MarekWadinger/firmware-one-openair/docs/3d/reference/Complete Assembly 11AUG22.stp

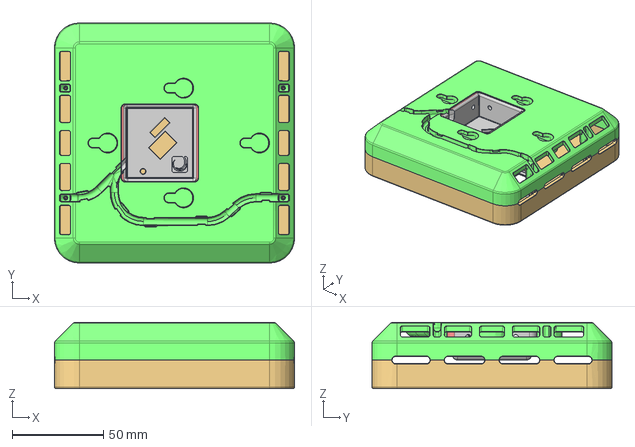
[picture p1: CAD file, 2026-10-09]
docs/3d/reference/Complete Assembly 11AUG22.stp
131.2 x 131.2 x 36.2 mm
