MarekWadinger/firmware-one-openair/docs/3d/reference/airgradient-stand-stl.stl

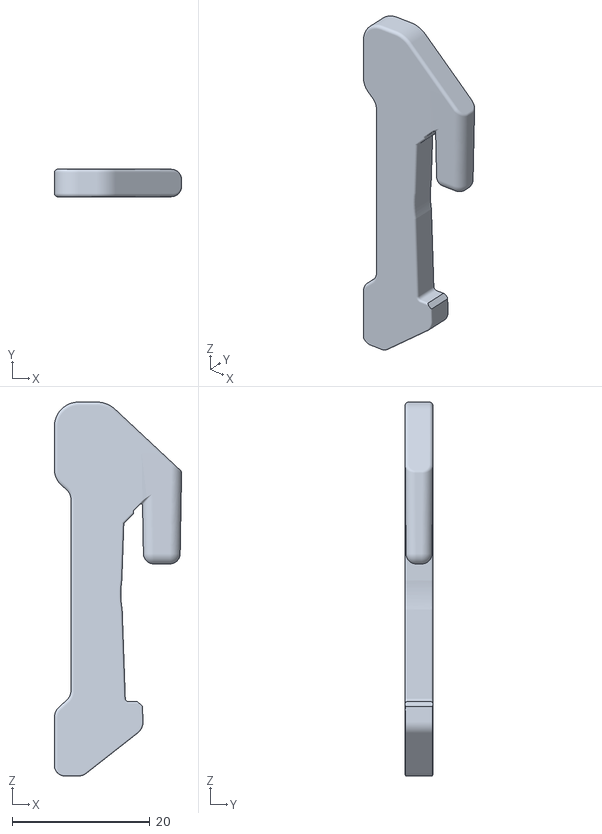
[picture p2: CAD file, 2026-10-09]
docs/3d/reference/airgradient-stand-stl.stl
18.4 x 4.02 x 54.2
