MarekWadinger/firmware-one-openair/docs/3d/reference/Cable Area 11AUG22.stl

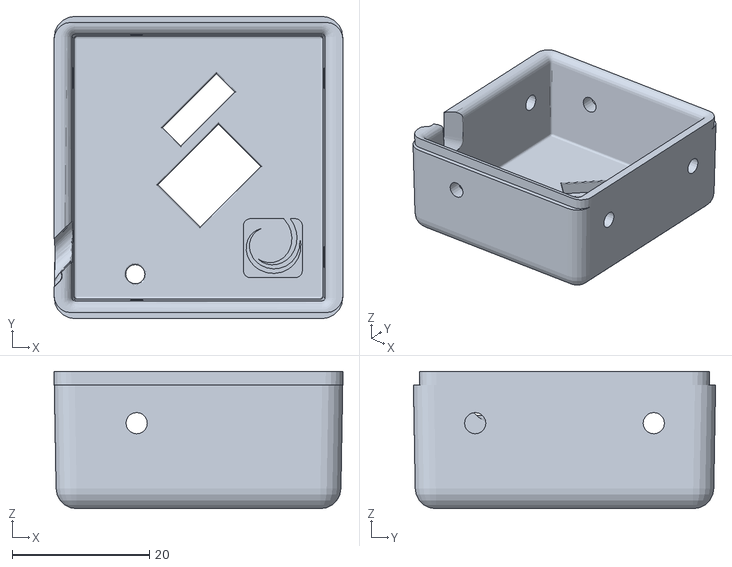
[picture p3: CAD file, 2026-10-09]
docs/3d/reference/Cable Area 11AUG22.stl
42.1 x 44.0 x 20.0
