MarekWadinger/firmware-one-openair/docs/3d/reference/Upper Case 11AUG22.stl

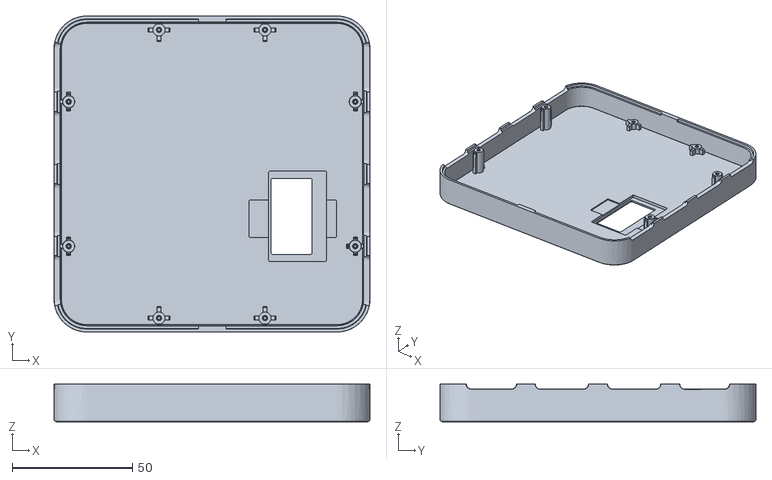
[picture p4: CAD file, 2026-10-09]
docs/3d/reference/Upper Case 11AUG22.stl
131.2 x 131.2 x 15.6
