MarekWadinger/firmware-one-openair/docs/3d/reference/Lower Case 11AUG22.stl

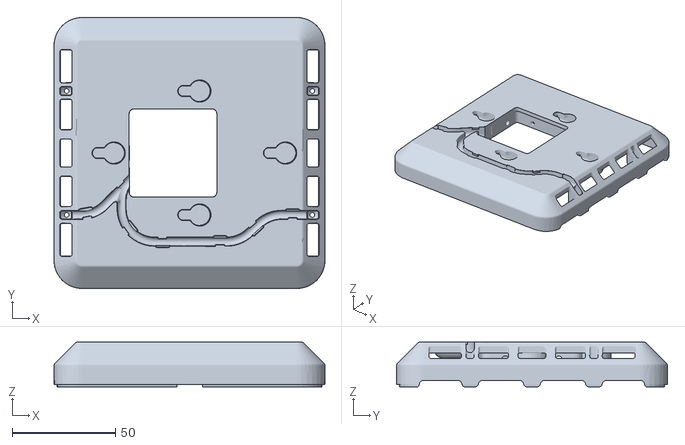
[picture p5: CAD file, 2026-10-09]
docs/3d/reference/Lower Case 11AUG22.stl
131.2 x 131.2 x 21.7
