MarekWadinger/firmware-one-openair/(commit log)

2026-09-25 chore: build from any checkout folder name, ignore .venv
    platformio.ini pointed lib_deps at ../arduino, which only works when the
    repo is cloned as 'arduino'. Use ${PROJECT_DIR} instead. Also ignore the
    project uv venv used for serial tooling.
2026-09-25 feat: add I2C bus diagnostic sketch
    Prints SDA/SCL idle levels, scans all addresses, sends the DFRobot gas
    sensor command frame to 0x74-0x77 at two bus speeds, and probes UART at
    several baud rates in case the sensor's SEL switch is on UART. Build with
    PLATFORMIO_SRC_DIR=examples/I2CScan, no platformio.ini edit needed.
2026-09-25 feat: DFRobot SEN0466 CO sensor and buzzer for AirGradient ONE
    - Read CO every 2 s over I2C (0x74) with the raw DFRobot frame protocol,
    no extra library. Sensor is set to passive mode at boot.
    - Show CO in the OLED top row between temperature and humidity, on every
    dashboard variant.
    - Buzzer on GPIO3 (shared with the cellular reset line): held LOW from
    the first line of setup and again after agSerial init, beeps 1 s per
    cycle while CO >= CO_ALARM_PPM (50).
    - Set the sensor's own ALA threshold alarm to the same level at every
    boot, before the network step, with retries and an alarm-off fallback;
    the setting persists inside the sensor.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
    [AgOledDisplay.cpp, AgOledDisplay.h, OneOpenAir.ino]
2026-09-25 docs: hardware reference and diagnosis for the CO sensor mod
    Board pinout from the KiCad file, sensor protocol, wiring as built, the
    I2C1 solder-joint diagnosis, buzzer and ALA findings, OTA safety note.
    CLAUDE.md slimmed to status and pointers.
2026-09-25 feat: 3D-printable CO sensor box clipping onto the case top
    Parametric generator (trimesh + manifold) and STLs. The box is centred
    on the top edge and carries two hooks whose profile is cut from the
    official AirGradient stand model, so it slides into the case's top
    sockets exactly like the stand does at the bottom. Vent slots in the
    lid and floor, posts for the sensor's 30 x 25 mm hole grid, cable notch
    at the rear. CELL_H still needs a real measurement.
    [co_sensor_box_body.stl, co_sensor_box_lid.stl]
2026-09-25 feat: sensor box v2, sensor upright with front opening
    Box depth equals the case depth. The sensor board stands on posts on
    the back wall with its cell facing forward through a round opening.
    Two floor openings sit exactly on the case's two vent slots between
    the sockets, measured from the case model.
    [co_sensor_box_body.stl]
2026-09-25 feat: sensor box v3, buzzer on the front wall
    CO sensor hard left on the back wall, plug facing right so its cable
    drops through the left floor opening into the case. DFR0032 buzzer hard
    right on two posts on the front wall, poking through its own opening,
    cable through the right floor opening. Dimensions from DFRobot's
    drawing. Outer shape unchanged from v2; rear cable notch removed.
    [co_sensor_box_body.stl]
2026-09-25 feat: sensor box v4, case-style curvature and removable front plate
    Rounded top corners on the front face like the AirGradient, square in
    the top view. 64 mm wide so the hooks are flush with the sides. The box
    is a tube closed at the back; the front plate is the removable part and
    carries the buzzer posts and both openings. CO sensor on the back wall,
    left; buzzer on the plate, right; the cell clears the buzzer board.
    Generator prints the cell-to-buzzer clearance.
    [co_sensor_box_body.stl, co_sensor_box_front.stl, co_sensor_box_lid.stl]
2026-09-25 feat: box top gets two vent slots matching the floor openings
    [co_sensor_box_body.stl]
2026-09-25 feat: box rounds all four front corners over a 2 mm base plate
    [co_sensor_box_body.stl, co_sensor_box_front.stl]
2026-09-25 feat: box 73 mm wide so the corner curves clear the hooks, no base plate
    [co_sensor_box_body.stl, co_sensor_box_front.stl]
2026-09-25 fix: sink the hooks 0.3 mm into the floor for a solid joint
    [co_sensor_box_body.stl]
2026-09-25 feat: perforated back wall and top-rear chamfer on the sensor box
    Staggered grid of small holes across the back wall, kept clear of the
    sensor posts and the corner curves, plus a 2 mm chamfer on the top-rear
    edge, after the case's perforated, slightly tilted back.
    [co_sensor_box_body.stl]
2026-09-25 Revert "feat: perforated back wall and top-rear chamfer on the sensor box"
    This reverts commit c0e4c288b66964acb3e218c6f1c556bd3a0c5f3d.
    [co_sensor_box_body.stl]
2026-09-25 feat: sensor box with measured cell (24 x 25) and buzzer (8) sizes
    [co_sensor_box_front.stl]
2026-09-25 feat: front openings cut at part size, buzzer sits just behind the plate
    [co_sensor_box_front.stl]
2026-09-28 feat: publish CO ppm in the local /measures/current JSON
    Adds a co field on Measurements, filled from the DFRobot SEN0466 read
    loop and emitted only for the local server. Sets the ALA alarm
    threshold to 50 ppm with the EN 50291 / WHO reference table.
2026-09-29 refactor: drop the unused GPIO3 buzzer path; OLED reads CO from Measurements
    The buzzer is driven by the SEN0466 ALA pin; tone() on GPIO3 drove
    nothing. Removes BUZZER_PIN, TEST_BUZZER_CO2_PPM, the LOW pulls and the
    display's private copy of the CO value.
    [AgOledDisplay.cpp, AgOledDisplay.h, OneOpenAir.ino]
2026-09-29 chore: remove one-off I2C bus scanner sketch (address 0x74 is documented)
2026-09-29 chore: stop committing generated STL binaries
    [co_sensor_box_body.stl, co_sensor_box_front.stl]
2026-10-09 feat: cell opening 1 mm wider so the cell can pass through the plate
    Claude-Session: https://claude.ai/code/session_01ErfzUqv9mfBfkHcTr23CRv
2026-10-09 feat: measured cylinder heights, CO posts shortened so the cell stands proud
    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
2026-10-09 feat: box corner radius 7.5 mm, same proportion as the case
    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
2026-10-09 fix: CO posts 7.4 mm so the cell stands proud of the plate (was shortened by mistake)
    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
2026-10-09 fix: centre both boards vertically in the box
    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
2026-10-09 docs: keep AirGradient's published case and stand models as reference
    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
    [Cable Area 11AUG22.stl, Complete Assembly 11AUG22.stp, Lower Case 11AUG22.stl, Upper Case 11AUG22.stl, airgradient-stand-stl.stl]
2026-10-09 fix: hook gap 3.4 mm so the head clears the case's 3.0 mm lip
    The hook was sunk 0.3 mm into the floor for a solid joint, which shrank
    the gap under the floor to 2.7 mm (2.6 printed) against a 3.0 mm lip.
    Keep the head where the stand has it and shave its top instead; the
    0.3 mm strip beyond the face plane already joins it to the floor.
    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
2026-10-09 fix: measured cylinder diameters (23.34 / 11.78), both openings part + 0.8
    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
2026-10-09 fix: pad under the corner curve at each hook so it joins solid material
    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
2026-10-09 Revert "fix: pad under the corner curve at each hook so it joins solid material"
    This reverts commit 1250d594b8e5f6ccfd6e558b758f5a377a497b46.
2026-10-09 fix: head shave runs to the ramp foot, no ledge on the hook's top
    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
2026-10-09 fix: hooks are a 3D copy of the stand's tongue, with its taper and chamfers
    The extruded profile was a flat 4.0 mm bar; the real tongue tapers to
    ~3 mm at the neck and ~3.6-3.9 at the head, which is what lets it slide
    into the 3.9 mm socket.
    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
2026-10-09 feat: 1 mm round on the front plate's outer edge, as on the case
    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
2026-10-09 feat: 2.2 x 3.0 mm slope on the box's top-rear edge, as on the case
    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
2026-10-09 feat: slope on all four rear edges with 1 mm rounds, cavity follows, hook tails end at the slope
    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
2026-10-09 fix: hook tails reach the back plane so they stand on the bed
    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
2026-10-09 feat: hook heel sloped like the rear edge, 1.8 mm flat on the bed
    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
2026-10-13 docs: add GY-BME/PMP280 pressure sensor plan for the BME footprint
2026-10-13 docs: add MLX90640 thermal camera fallback plan for I2C2
